AK-Homberger/Alexa-Alarm-System-ESP32CAM/Pictures/RPIHC-SR501_5.png

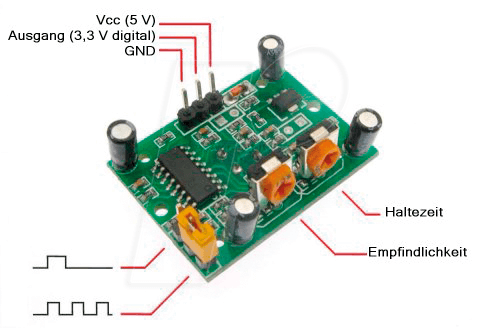
Pictures/RPIHC-SR501_5.png
