AK-Homberger/Alexa-Alarm-System-ESP32CAM/AlexaAlarmSystem-Sensor/certificate.h

// Root certificate for www.virtualsmarthome.xyz
const char rootCACertificate[] PROGMEM = R"=====(
-----BEGIN CERTIFICATE-----
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
-----END CERTIFICATE-----
)=====";
