AK-Homberger/Alexa-Alarm-System-ESP32CAM/(commit log)

2021-11-26 Store picture to SPIFFS only when active.
    To avoid unnecessary flash usage.
    [AlexaAlarmSystem.ino]
2021-12-08 Version with additional CCS811 air quality sensor
2022-02-16 Avoid millis() rollover problem.
    [AlexaAlarmSystem.ino]
